YANGJONGSU/jongky/README.md

> **3인 팀 프로젝트** (2026.07–08, 교육과정 밖 자체 진행)
> **내 역할:** 강화학습 · 로봇 시스템: 하드웨어 설계부터 SLAM, Isaac Lab 강화학습, 실물 이식까지 전 과정 참여, 저장소 구조와 팀 문서 체계 설계
> **자세히:** https://jongky.site/projects/jongky

# jongky_magic

jongky는 특정 장소의 가이드를 수행하는 VLM 기반 자율주행 로봇입니다.

이 README는 프로젝트의 진입점입니다. 무엇을 하는 프로젝트인지, 저장소가 어떻게 나뉘어 있는지,
어떤 문서를 언제 봐야 하는지, 팀이 어떻게 협업하는지를 여기서 먼저 파악하세요.

## 문서 가이드

| 문서 | 언제 보나 |
|---|---|
| [docs/mission.md](docs/mission.md) | 임무 정의와 성공 기준이 궁금할 때 |
| [docs/architecture.md](docs/architecture.md) | 계층 구조와 계약(interface contract)을 볼 때 |
| [docs/conventions.md](docs/conventions.md) | 좌표계·단위·메쉬 규약 — **메쉬/CAD 작업 전 필독** |
| [docs/interfaces.md](docs/interfaces.md) | msg/action/POI 스키마 목록 |
| [docs/adr/](docs/adr/) | 왜 그 기술/설계를 선택했는지 (ROS distro, VDA5050, Zenoh) |
| [docs/collaboration.md](docs/collaboration.md) | 팀 역할 분담, 진척 게이트(G0~G7), 협업 규약 |
| [docs/trace.md](docs/trace.md) | 임무 한 건이 질의→모터까지 어떤 경로를 타는지 |
| [docs/troubleshooting.md](docs/troubleshooting.md) | 뭐가 안 됐고 어떻게 알아냈는지 |
| [docs/faq.md](docs/faq.md) | 팀원 간 상호 질의에서 나온 것들 |
| [docs/benchmarks/](docs/benchmarks/) | 성능/지연 벤치마크 결과 |

## 저장소 구조

```
jongky_magic/
├── docs/            # 위 문서 가이드 전체
├── interfaces/       # msg/action + POI 스키마 (변경 시 3인 승인 필수)
├── robot/            # 단일 로봇: description, bringup, hardware, control, navigation
├── fleet/            # 다중 로봇 운영: vda5050, rmf, mission
├── comms/            # zenoh-bridge-ros2dds
├── sim/              # Gazebo 시뮬레이션 + 월드
├── tools/            # 개발/운영 보조 스크립트
└── docker/           # 빌드/실행 컨테이너
```

각 패키지 디렉토리 안의 README.md에 해당 패키지의 역할이 짧게 적혀 있습니다.

## 팀 & 역할

3인 풀스택 체제로 운영합니다. 소유는 최종 책임이지 독점이 아닙니다 — 상세는 [docs/collaboration.md](docs/collaboration.md) 참고.

| | A — 플랫폼/주행 | B — 임무/관제 | C — 인식/인터랙션 |
|---|---|---|---|
| 소유 | `robot/`, `sim/` | `fleet/`, `comms/`, `interfaces/` | `perception/`, POI, 월드 자산 |
| 핵심 | URDF, ros2_control, CAN FD, Nav2, SLAM | 임무 상태머신, VDA5050, Open-RMF, Zenoh | VLM, POI 매핑, 뎁스 카메라, 센서 배치 |

## 진행 상태

현재 G0(계약) 단계 — 저장소 뼈대와 규약 문서 작성 완료, `interfaces/`의 stub 노드와 CI는 아직 없음.
게이트 전체 흐름은 [docs/collaboration.md](docs/collaboration.md#4-진척-게이트)에서 확인하세요.

메쉬는 A 트랙의 G6(실물)만 막습니다 — 나머지 트랙은 지금 바로 진행하면 됩니다.

## 시작하기

> TODO — G0 stub 노드 완성 후 실제 실행 경로로 갱신

```
# 시뮬레이션 (예정)
ros2 launch jongky_bringup guide.launch.py use_sim:=true

# 목업 하드웨어 (예정)
ros2 launch jongky_bringup guide.launch.py use_mock:=true

# 실물 (예정, G6 이후)
ros2 launch jongky_bringup guide.launch.py
```

## 기여 규칙

- `interfaces/` 변경은 A/B/C 3인 승인 없이 머지 금지
- 버그는 담당자가 아닌 사람이 먼저 봄 (디버그 우선권 역전) — [docs/collaboration.md](docs/collaboration.md#3-전원-풀스택-장치-3개)
- 메쉬/CAD 관련 작업 전 [docs/conventions.md](docs/conventions.md) 체크리스트 확인
