YANGJONGSU/jongky/sim/jongky_gz_sim/README.md

# jongky_gz_sim

Gazebo 시뮬레이션 launch/plugin. (TODO)
