YANGJONGSU/jongky/sim/jongky_gz_worlds/README.md

# jongky_gz_worlds

10F, 11F, 엘리베이터 로비 월드. (TODO)
