YANGJONGSU/jongky/robot/jongky_description/meshes/visual/base_link.stl

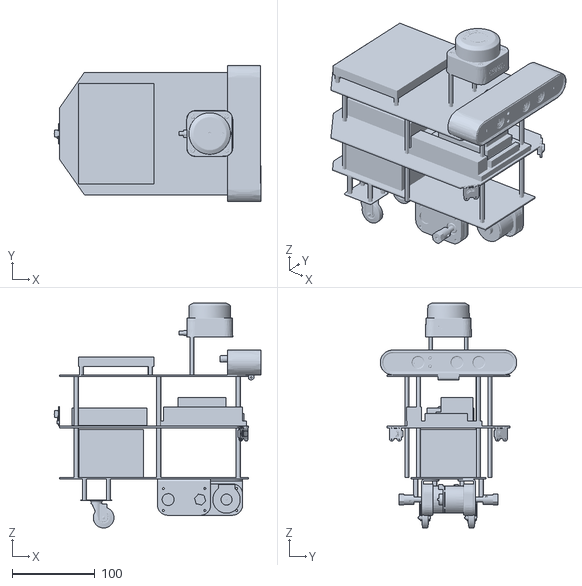
[picture p1: CAD file, 2026-10-06]
robot/jongky_description/meshes/visual/base_link.stl
249.5 x 164.9 x 271.8
