YANGJONGSU/jongky/robot/jongky_description/meshes/visual/wheel.stl

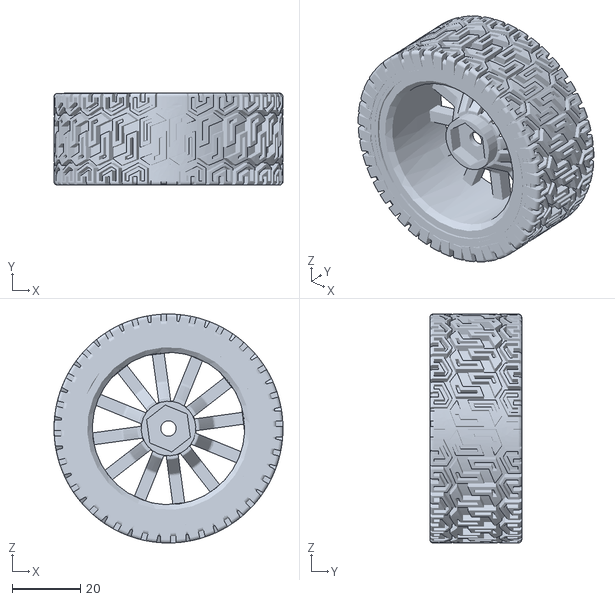
[picture p2: CAD file, 2026-10-06]
robot/jongky_description/meshes/visual/wheel.stl
67.0 x 27.1 x 67.0
