YANGJONGSU/jongky/docs/troubleshooting.md

# Troubleshooting

> 문제당 네 줄: 증상 / 원인 / 해결 / 알아낸 방법. 마지막 줄이 가장 변별력 있는 면접 질문의 답입니다.
> 통합 당번이 통합 사이클마다 갱신.

## 형식

```
### [짧은 제목]
- 증상:
- 원인:
- 해결:
- 알아낸 방법:
```

---

### RPLIDAR C1 이 Cannot start scan 으로 죽는다
- 증상: `rplidar_composition` 이 S/N·펌웨어·health 는 정상으로 읽고 `Start`
  까지 찍은 뒤 `Cannot start scan: '80008002'` → `Failed to set scan mode`
  로 종료. `scan_mode:=Standard` 를 주면 `'80008000'` 으로 바뀔 뿐이다.
- 원인: apt 의 `ros-jazzy-rplidar-ros` 는 2.1.0 이고 SDK 1.12.0 을 쓴다.
  패키지 설명이 "support rplidar A2/A1 and A3/S1" 이고 런치 파일도 a3·s1
  뿐이다 — **C1 이 나오기 전 버전이다.** 지원 모드 목록에 C1 이 없으니
  express scan 협상이 타임아웃(`80008002` = `RESULT_OPERATION_TIMEOUT`)
  하고, 모드 이름을 직접 주면 매칭에 실패한다(`80008000` =
  `RESULT_INVALID_DATA`).
- 해결: Slamtec `ros2` 브랜치를 소스로 받아 워크스페이스에서 빌드한다
  (SDK 2.1.0, `rplidar_c1_launch.py` 포함). `robot/jongky_robot.repos` 에
  커밋을 고정해 뒀다. Dockerfile 에서는 apt 판을 **뺐다** — 오버레이를
  안 잡으면 조용히 깨진 버전이 쓰이기 때문이다.
  ```bash
  ros2 launch rplidar_ros rplidar_c1_launch.py serial_port:=/dev/rplidar frame_id:=laser
  # → current scan mode: Standard, 5 Khz, max 16.0 m, 10.0 Hz
  ```
- 알아낸 방법: 파라미터를 의심해 보드레이트(256000→460800)와 `scan_mode` 를
  차례로 바꿔 봤지만 오류 코드만 바뀌었다. 방향을 돌린 건 **연결 자체는
  성공한다**는 점이다 — 시리얼·전원·권한이 다 정상인데 스캔 명령만 실패하면
  남는 건 프로토콜 협상이고, 그건 SDK 버전 문제다. 로그의
  `SDK Version: '1.12.0'` 과 `dpkg -l` 의 지원 모델 목록에서 확인했다.
  같은 장비를 순수 시리얼(`tools/lidar_yaw.py`)로는 계속 돌릴 수 있었던
  것도 "하드웨어는 멀쩡하다" 는 근거였다.

### 가만히 있는 로봇이 기동 직후 odom 상 0.6m 움직인다
- 증상: 브링업 직후 `odom -> base_footprint` 가 `[0.378, 0.496]`, yaw 105도.
  그 뒤로는 **전혀 드리프트하지 않는다**(12초간 변화 0). 한 번만 튄다.
- 원인: 야붐 엔코더는 보드 전원 인가 이후 누적값이라 원점을 잡아야 하는데,
  그걸 `on_activate` 에서 했다. `on_configure` 와 `on_activate` 사이는 1ms 도
  안 되는 반면 **보드 엔코더 보고는 25Hz(40ms)** 다. 아직 프레임이 없어
  `snapshot()` 이 0 을 주고, 그 0 을 원점으로 삼았다. 로그에
  `엔코더 원점 좌=0 우=0` 으로 찍힌다. 첫 프레임이 오는 순간 **보드를 켠 뒤
  누적된 전량**(좌 −294717 / 우 −401988 counts = 952 / 1298 rad)이 한 번에
  관절 변화로 들어간다.
- 해결: 원점을 `read()` 로 미뤄 **첫 엔코더 프레임에서** 잡는다.
  `encoder_seq == 0` 이면 아직 프레임이 없다는 뜻이므로 그동안은 상태를
  건드리지 않는다. 고친 뒤 로그가 `엔코더 원점 좌=-294717 우=-401988` 로
  바뀌고 odom 은 0 에서 시작한다.
- 알아낸 방법: **드리프트가 아니라 한 번만 튄다**는 게 갈림길이었다.
  계속 흐르면 센서 잡음이나 스케일 문제지만, 한 번 튀고 마는 건 초기화
  문제다. 관절값이 952 rad(151회전)로 물리적으로 불가능하다는 점과,
  로그의 `원점 좌=0 우=0` 이 곧바로 원인을 가리켰다.

### 컨테이너 안에서 pkill 을 했더니 호스트 셸이 죽었다
- 증상: `docker exec ... pkill -f "ros2 launch"` 를 넣은 ssh 명령이 아무 출력
  없이 끝난다. 뒤에 붙인 `echo` 조차 안 찍힌다.
- 원인: 컨테이너를 `--pid host` 로 띄우면 **컨테이너 안의 pkill 이 호스트
  프로세스까지 본다.** 그 명령을 실어 나르던 호스트 셸의 cmdline 에
  `ros2 launch ...` 문자열이 그대로 들어 있어서 자기 자신을 죽였다.
  `[r]os2` 같은 대괄호 트릭도 소용없다 — 패턴이 아니라 **대상의 cmdline** 에
  그 문자열이 있는 게 문제다.
- 해결: `--pid host` 를 뺐다(`run_robot.sh`). ROS 2 에는 필요 없다 —
  DDS 공유메모리는 `/dev/shm` 마운트로 충분하고, 전 스택을 없이 돌려 확인했다.
  스택을 내릴 때는 `pkill` 대신 `docker rm -f` 로 컨테이너째 내린다.
- 알아낸 방법: 명령 전체가 무출력으로 끝나는 건 원격 셸이 죽었다는 뜻이다.
  어떤 패턴이 그 셸의 cmdline 과 겹치는지 되짚어 보니 바로 나왔다.

### 라이다가 전 방향 3~6cm 로 균일하게 나온다
- 증상: 스캔은 정상적으로 도는데 모든 각도의 거리가 34~63mm 로 비슷하다.
  사방이 막힌 것처럼 보이지만 실제로는 트인 공간이다.
- 원인: 구입 시 감겨 있던 **보호필름을 안 벗겼다.** 레이저가 필름에서 바로
  반사돼 그 너머를 못 본다.
- 해결: 필름 제거. 바로 228~2560mm 로 정상화.
- 알아낸 방법: 고장이면 값이 안 나오거나 튀는데, **값은 멀쩡하고 전부 작기만**
  했다. 거리 분포가 물리적으로 불가능(로봇이 5cm 상자 안에 있다는 뜻)하다는
  점에서 센서 앞을 의심했다.

### URDF 를 고쳤는데 TF 가 안 바뀐다
- 증상: xacro 를 수정하고 재배포했는데 `ros2 run tf2_ros tf2_echo` 결과가
  그대로다.
- 원인: 빠른 재배포가 `ros2_control_node` 만 죽였다. **TF 를 발행하는 건
  `robot_state_publisher`** 고, 그건 옛 URDF 를 들고 살아 있었다.
- 해결: URDF 를 고쳤으면 런치 그룹 전체를 죽이고 다시 띄운다.
  ```bash
  pkill -f ros2_control_node; pkill -f robot_state_publisher; pkill -f "ros2 launch"
  ```
- 알아낸 방법: 컨트롤러 YAML 만 고칠 때는 같은 절차로 잘 반영됐다는 점.
  차이는 "누가 그 값을 들고 있느냐" 였다.
